darchons/tbhb/eagle/tbhb.brd

## EAGLE design eagle/tbhb.brd (2013-04-26)

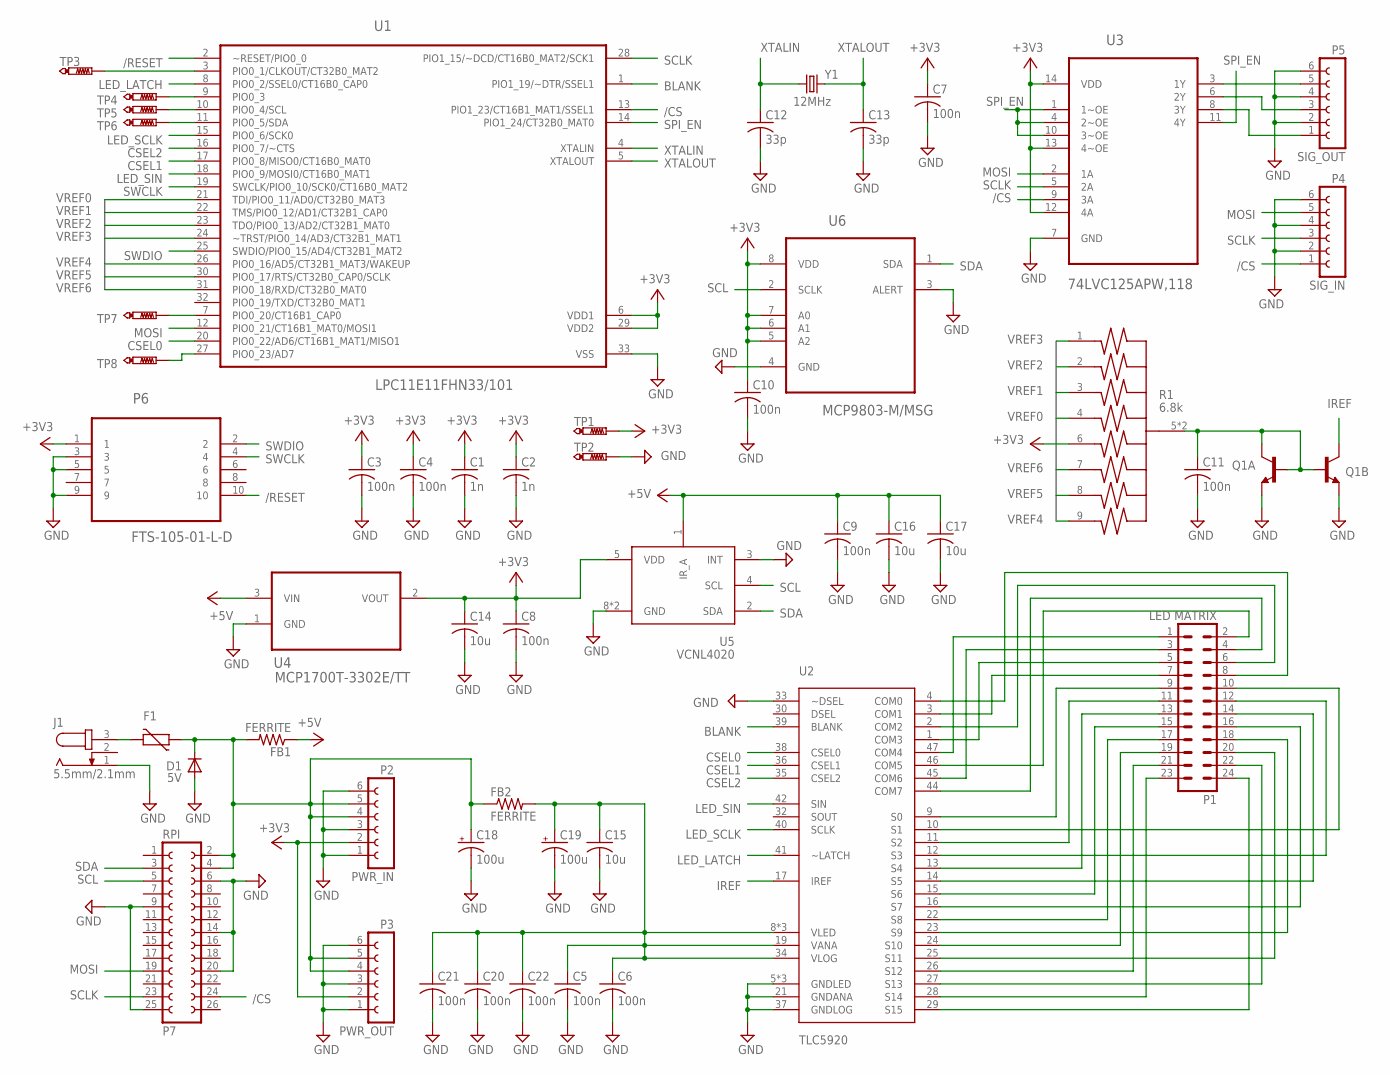
[picture p1: schematic tbhb.sch]

Parts:
C1, C2: 1n; C0603
C3, C4, C5, C6, C7, C8, C9, C10, C11, C20, C21, C22: 100n; C0603
C12, C13: 33p; C0603
C14, C15, C16, C17: 10u; C0805
C18, C19: 100u; CT6032; PARTNUMBER TR3C107K010C0200
D1: 5V; SOD123
F1: 2A; CT/CN1812
FB1, FB2: FERRITE; R0603
J1: 5.5mm/2.1mm; SPC4077-1
P1: LED MATRIX; MA12-2
P2: PWR_IN; FE06
P3: PWR_OUT; FE06
P4: SIG_IN; FE06
P5: SIG_OUT; FE06
P6: FTS-105-01-L-D; SAMTEC_FTS-105-01-L-D
P7: RPI; FE13-2
Q1: CMLT5088E; SOT563
R1: 6.8k; EXBD10C
TP1, TP2, TP3, TP4, TP5, TP6, TP7, TP8: PTR1TP15R; TP15R
U1: LPC11E11FHN33/101; QFN65P700X700X100-33N
U2: TLC5920; SOP63P1035X279-48N
U3: 74LVC125APW,118; SOP65P640X110-14N
U4: MCP1700T-3302E/TT; SOT95P237X112-3N
U5: VCNL4020
U6: MCP9803-M/MSG; SOP65P490X110-8N
Y1: 12MHz; CRYSTAL-50X32

Connections:
+3V3: C1.1, C2.1, C3.1, C4.1, C7.1, C8.1, C10.1, C14.1, P2.2, P3.2, P6.1, R1.6 (5), TP1.TP, U1.6 (VDD1), U1.29 (VDD2), U3.12 (4A), U3.13 (4~OE), U3.14 (VDD), U4.2 (VOUT), U5.5 (VDD), U6.5 (A2), U6.6 (A1), U6.7 (A0), U6.8 (VDD)
+5V: C9.1, C16.1, C17.1, FB1.1, U4.3 (VIN), U5.1 (IR_A)
/CS: P4.1, P7.24, U1.13 (PIO1_23/CT16B1_MAT1/SSEL1), U3.9 (3A)
/RESET: P6.10, U1.2 (~RESET/PIO0_0)
BLANK: U1.1 (PIO1_19/~DTR/SSEL1), U2.39 (BLANK)
CSEL0: U1.20 (PIO0_22/AD6/CT16B1_MAT1/MISO1), U2.38 (CSEL0)
CSEL1: U1.17 (PIO0_8/MISO0/CT16B0_MAT0), U2.36 (CSEL1)
CSEL2: U1.16 (PIO0_7/~CTS), U2.35 (CSEL2)
GND: C1.2, C2.2, C3.2, C4.2, C5.2, C6.2, C7.2, C8.2, C9.2, C10.2, C11.2, C12.2, C13.2, C14.2, C15.2, C16.2, C17.2, C18.-, C19.-, C20.2, C21.2, C22.2, D1.A, J1.1, P2.1, P2.3, P2.6, P3.1, P3.3, P3.6, P4.2, P4.4, P4.6, P5.2, P5.4, P5.6, P6.3, P6.5, P6.9, P7.6, P7.9, P7.14, P7.20, P7.25, Q1.1 (E), Q1.4 (E), TP2.TP, U1.33 (VSS), U2.5 (GNDLED), U2.21 (GNDANA), U2.33 (~DSEL), U2.37 (GNDLOG), U2.43 (GNDLED), U2.48 (GNDLED), U3.7 (GND), U4.1 (GND), U5.3 (INT), U5.8 (GND), U5.9 (GND), U6.3 (ALERT), U6.4 (GND)
IREF: Q1.3 (C), U2.17 (IREF)
LED_LATCH: U1.8 (PIO0_2/SSEL0/CT16B0_CAP0), U2.41 (~LATCH)
LED_SCLK: U1.15 (PIO0_6/SCK0), U2.40 (SCLK)
LED_SIN: U1.18 (PIO0_9/MOSI0/CT16B0_MAT1), U2.42 (SIN)
MOSI: P4.5, P7.19, U1.12 (PIO0_21/CT16B1_MAT0/MOSI1), U3.2 (1A)
unnamed: TP3.TP, U1.3 (PIO0_1/CLKOUT/CT32B0_MAT2)
unnamed: C18.+, D1.C, F1.1, FB1.2, FB2.1, P2.4, P2.5, P3.4, P3.5, P7.2, P7.4
unnamed: P1.1, U2.47 (COM4)
unnamed: P1.3, U2.45 (COM6)
unnamed: P1.5, U2.1 (COM3)
unnamed: P1.7, U2.3 (COM1)
unnamed: P1.8, U2.4 (COM0)
unnamed: P1.6, U2.2 (COM2)
unnamed: P1.4, U2.44 (COM7)
unnamed: P1.2, U2.46 (COM5)
unnamed: P1.9, U2.9 (S0)
unnamed: P1.11, U2.11 (S2)
unnamed: TP5.TP, U1.10 (PIO0_4/SCL)
unnamed: TP4.TP, U1.9 (PIO0_3)
unnamed: P1.23, U2.28 (S14)
unnamed: P1.24, U2.29 (S15)
unnamed: P1.12, U2.12 (S3)
unnamed: P1.22, U2.27 (S13)
unnamed: P1.21, U2.26 (S12)
unnamed: P1.19, U2.24 (S10)
unnamed: P5.1, U3.8 (3Y)
unnamed: P5.3, U3.6 (2Y)
unnamed: P5.5, U3.3 (1Y)
unnamed: C11.1, Q1.2 (B), Q1.5 (B), Q1.6 (C), R1.5 (C), R1.10 (C)
unnamed: F1.2, J1.3
unnamed: TP6.TP, U1.11 (PIO0_5/SDA)
unnamed: TP8.TP, U1.27 (PIO0_23/AD7)
unnamed: P1.20, U2.25 (S11)
unnamed: TP7.TP, U1.7 (PIO0_20/CT16B1_CAP0)
unnamed: P1.17, U2.22 (S8)
unnamed: P1.13, U2.13 (S4)
unnamed: P1.10, U2.10 (S1)
unnamed: P1.18, U2.23 (S9)
unnamed: P1.15, U2.15 (S6)
unnamed: P1.16, U2.16 (S7)
unnamed: P1.14, U2.14 (S5)
SCL: P7.5, U5.4 (SCL), U6.2 (SCLK)
SCLK: P4.3, P7.23, U1.28 (PIO1_15/~DCD/CT16B0_MAT2/SCK1), U3.5 (2A)
SDA: P7.3, U5.2 (SDA), U6.1 (SDA)
SPI_EN: U1.14 (PIO1_24/CT32B0_MAT0), U3.1 (1~OE), U3.4 (2~OE), U3.10 (3~OE), U3.11 (4Y)
SWCLK: P6.4, U1.19 (SWCLK/PIO0_10/SCK0/CT16B0_MAT2)
SWDIO: P6.2, U1.25 (SWDIO/PIO0_15/AD4/CT32B1_MAT2)
VLED: C5.1, C6.1, C15.1, C19.+, C20.1, C21.1, C22.1, FB2.2, U2.8 (VLED), U2.18 (VLED), U2.19 (VANA), U2.31 (VLED), U2.34 (VLOG)
VREF0: R1.4, U1.21 (TDI/PIO0_11/AD0/CT32B0_MAT3)
VREF1: R1.3, U1.22 (TMS/PIO0_12/AD1/CT32B1_CAP0)
VREF2: R1.2, U1.23 (TDO/PIO0_13/AD2/CT32B1_MAT0)
VREF3: R1.1, U1.24 (~TRST/PIO0_14/AD3/CT32B1_MAT1)
VREF4: R1.9 (8), U1.26 (PIO0_16/AD5/CT32B1_MAT3/WAKEUP)
VREF5: R1.8 (7), U1.30 (PIO0_17/RTS/CT32B0_CAP0/SCLK)
VREF6: R1.7 (6), U1.31 (PIO0_18/RXD/CT32B0_MAT0)
XTALIN: C12.1, U1.4 (XTALIN), Y1.1
XTALOUT: C13.1, U1.5 (XTALOUT), Y1.2

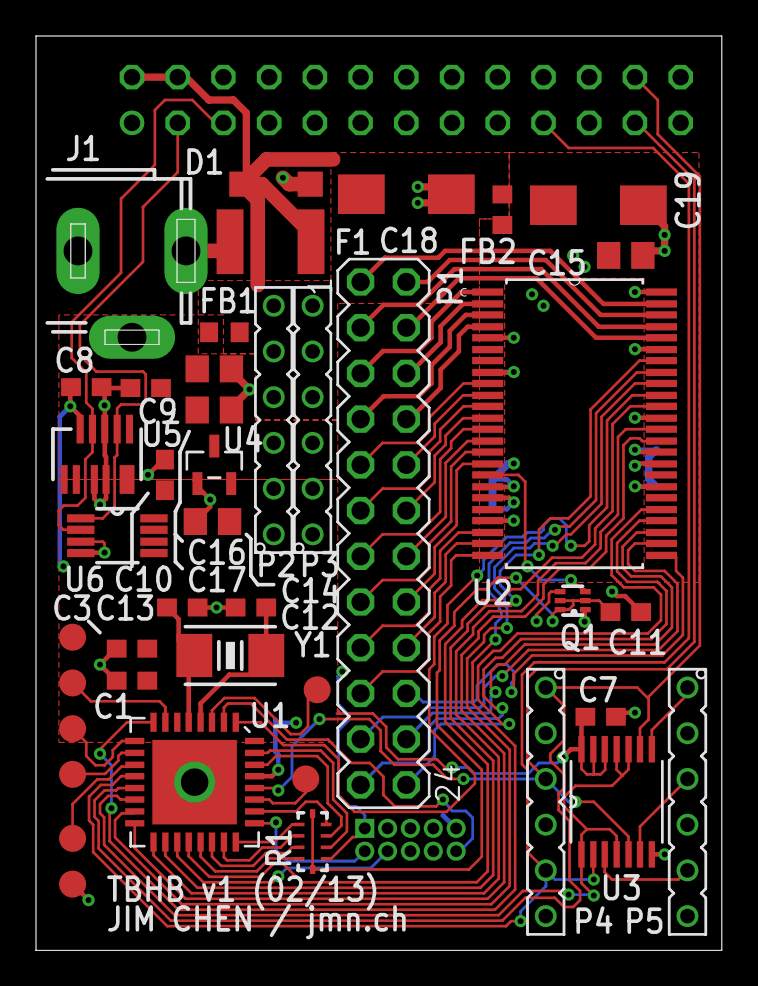
[picture p2: board tbhb.brd from above]

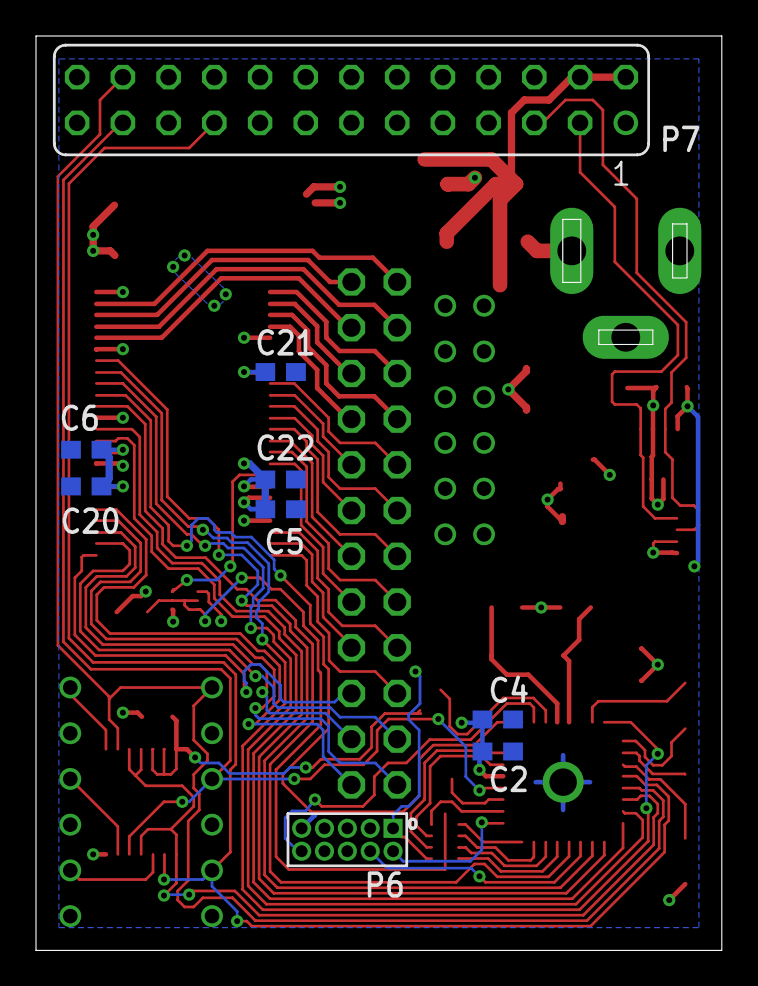
[picture p3: board tbhb.brd from below]

Board: 2 copper layers, 38.1 x 50.8 mm, 51 parts (9 on the bottom side), 66 nets.
