darchons/tbhb/(commit log)

2013-04-26 Initial files
    [tbhb.brd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]
2013-04-26 Fix firmware logic and line ending
    [host.h, main.c]
